darisoy/RobotArm/Frontend/frame.jpg

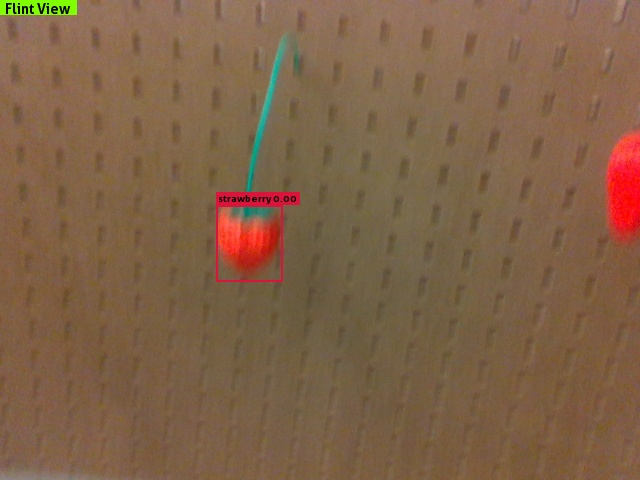
Frontend/frame.jpg
