darisoy/RobotArm/Frontend/client/data/frame.jpg

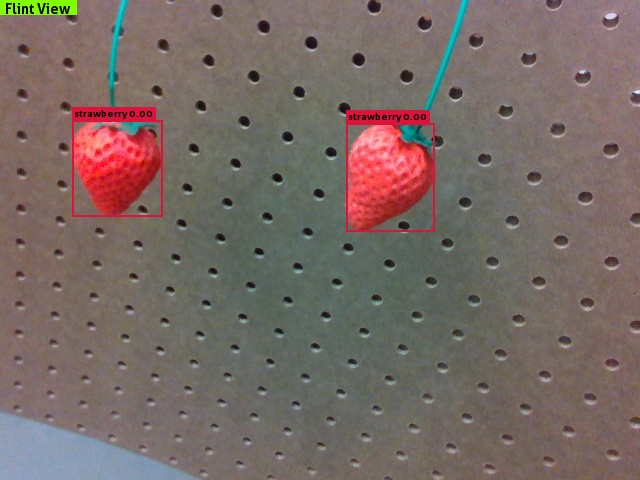
Frontend/client/data/frame.jpg
