darisoy/RobotArm/README.md

# Robot Arm

##### Strawberry picker robot arm capstone project for UW ECE/CSE 475

Final product demo: https://youtu.be/TgOqZ84XcAI
