darisoy/RobotArm/pi-dyna-test-env/link_descriptions/stl/hand_link.stl

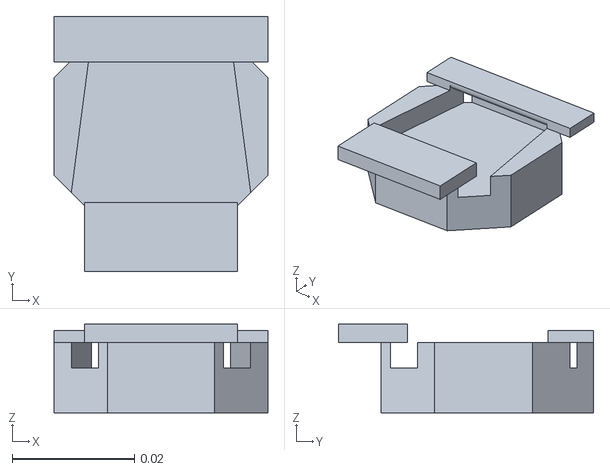
[picture p15: CAD file, 2020-02-03]
pi-dyna-test-env/link_descriptions/stl/hand_link.stl
0.035 x 0.0417 x 0.0145
