darisoy/RobotArm/pi-dyna-test-env/link_descriptions/stl/base_link.stl

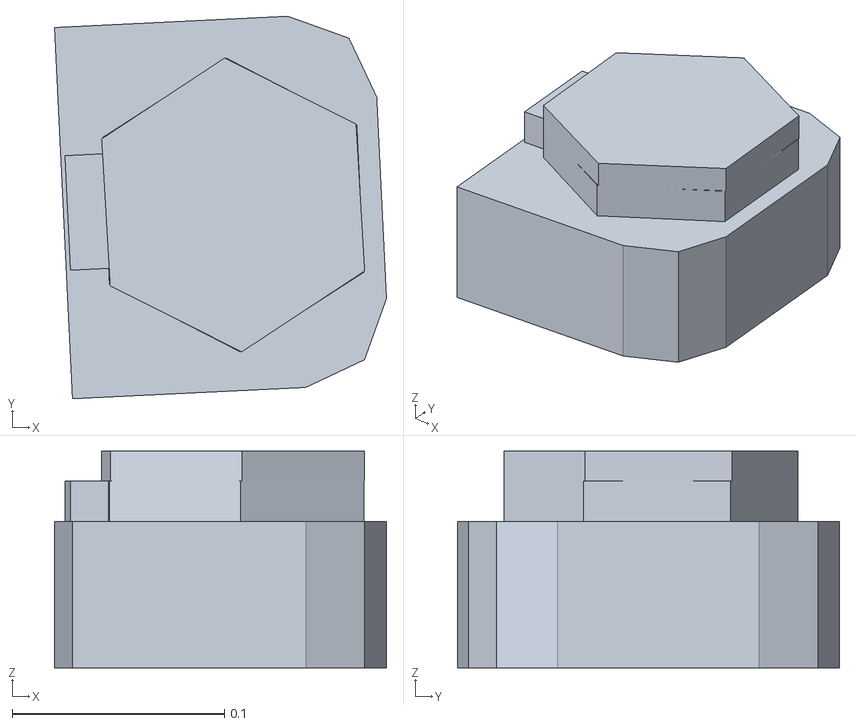
[picture p16: CAD file, 2020-02-03]
pi-dyna-test-env/link_descriptions/stl/base_link.stl
0.156 x 0.18 x 0.102
