darisoy/RobotArm/pi-dyna-test-env/link_descriptions/stl/shoulder_link.stl

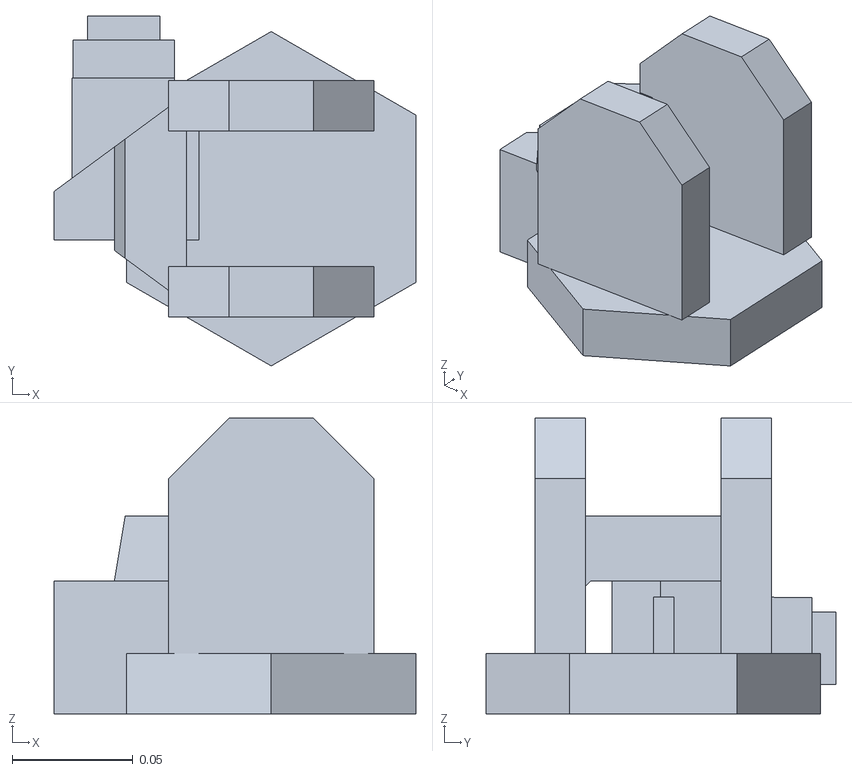
[picture p17: CAD file, 2020-02-03]
pi-dyna-test-env/link_descriptions/stl/shoulder_link.stl
0.15 x 0.145 x 0.123
