darisoy/RobotArm/pi-dyna-test-env/link_descriptions/stl/elbow_link.stl

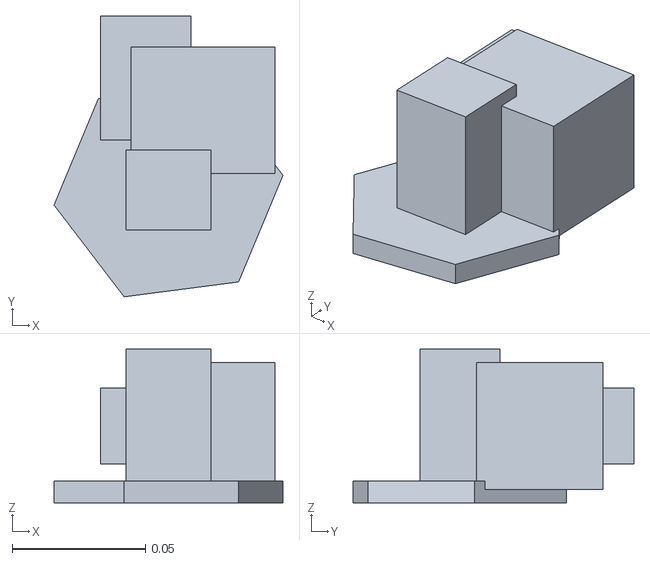
[picture p18: CAD file, 2020-02-03]
pi-dyna-test-env/link_descriptions/stl/elbow_link.stl
0.0859 x 0.105 x 0.0576
