darisoy/RobotArm/pi-dyna-test-env/link_descriptions/stl/arm_link.stl

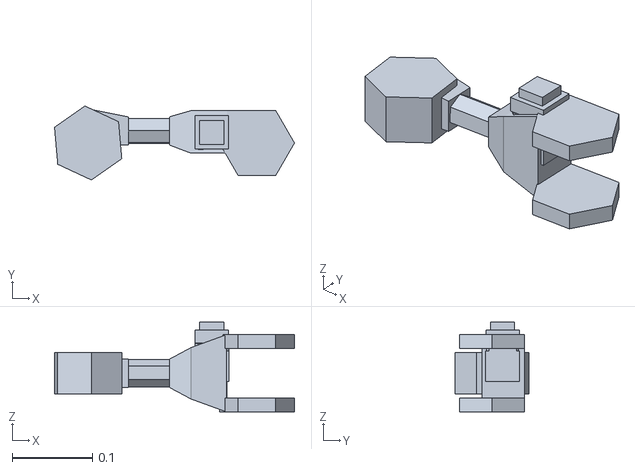
[picture p19: CAD file, 2020-02-03]
pi-dyna-test-env/link_descriptions/stl/arm_link.stl
0.299 x 0.092 x 0.112
