darisoy/RobotArm/pi-dyna-test-env/link_descriptions/stl/wrist_link.stl

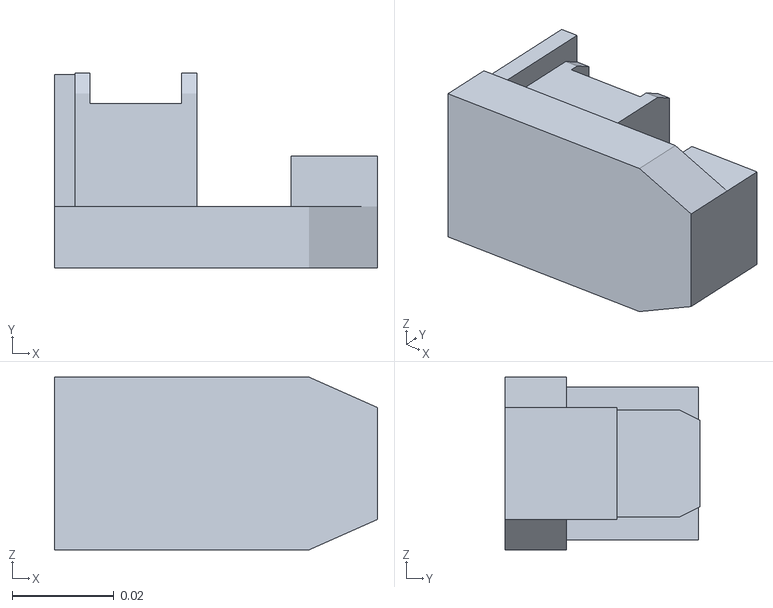
[picture p20: CAD file, 2020-02-03]
pi-dyna-test-env/link_descriptions/stl/wrist_link.stl
0.0635 x 0.0382 x 0.034
