darisoy/RobotArm/pi-dyna-test-env/link_descriptions/stl/forearm_link.stl

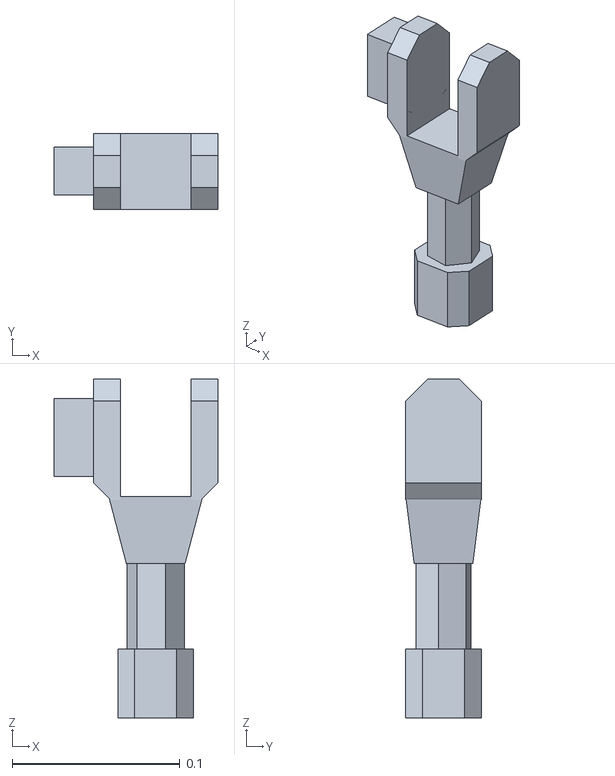
[picture p21: CAD file, 2020-02-03]
pi-dyna-test-env/link_descriptions/stl/forearm_link.stl
0.0975 x 0.045 x 0.202
