darisoy/RobotArm/(commit log)

2020-01-14 Initial commit with test code for raw test of arm
2020-01-14 Added StepperController.drawio
2020-01-26 Added StepperControllerUML.drawio
2020-01-30 stm32 kiel integration
2020-01-31 needs working queue and interrupt service routine
2020-01-31 URDF files
    [arm_link.stl, base_link.stl, controllers.yaml, elbow_link.stl, fake_controllers.yaml, forearm_link.stl, hand_link.stl, joint_limits.yaml]
2020-01-31 URDF file updated with links
    [arm_link.stl, base_link.stl, controllers.yaml, elbow_link.stl, fake_controllers.yaml, forearm_link.stl, hand_link.stl, joint_limits.yaml]
2020-02-02 UART trigger is working and queue. packet handler is next
2020-02-02 UART interrupt is working and Queue, need packet handler
2020-02-04 adding high level robot library
    [arm_link.stl, base_link.stl, elbow_link.stl, forearm_link.stl, hand_link.stl, niryo_one.urdf, shoulder_link.stl, wrist_link.stl]
2020-02-04 Replaced the queue with a large 200 character array that collects all UART input
    [Comm.cpp, Comm.h, main.cpp]
2020-02-05 update gitignore to include MDK-ARM compilation files
2020-02-05 Revert "timeout stuff + cleanup"
    This reverts commit 872d42c84c7b93859ebfd66977f3223622faaf6b.
    [ax12.py, robot.py, robotrunner.py]
2020-02-06 python -> stm stepper control
2020-02-06 working stepper arm
2020-02-06 all 3 servos working
2020-02-20 add functioning buttons
2020-02-26 Changed NiryoROS directory to add functionality for 57600 buaud and ID's 4,5,6
    [arm_link.stl, base_link.stl, controllers.yaml, elbow_link.stl, fake_controllers.yaml, forearm_link.stl, hand_link.stl, joint_limits.yaml]
2020-03-04 gripper stuff
2020-03-04 cleanup on isle 9
    [arm_link.stl, base_link.stl, controllers.yaml, elbow_link.stl, fake_controllers.yaml, forearm_link.stl, hand_link.stl, joint_limits.yaml]
2020-03-10 Working on STM32
2020-03-17 final cleanup
    [arm_link.stl, base_link.stl, elbow_link.stl, forearm_link.stl, hand_link.stl, niryo_one.urdf, shoulder_link.stl, wrist_link.stl]
